Fafixxx96/Embedded-Programming/schema.PNG

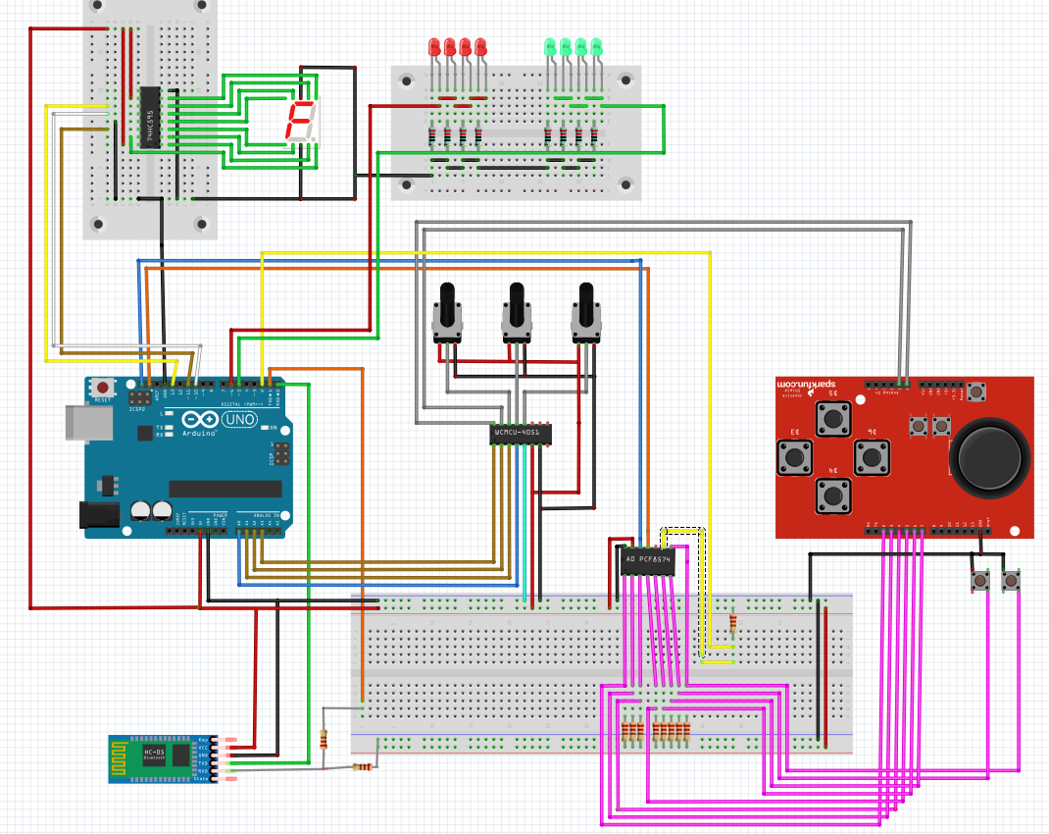
schema.PNG
