Fafixxx96/Embedded-Programming/Low Level_FabioC_214490.pdf

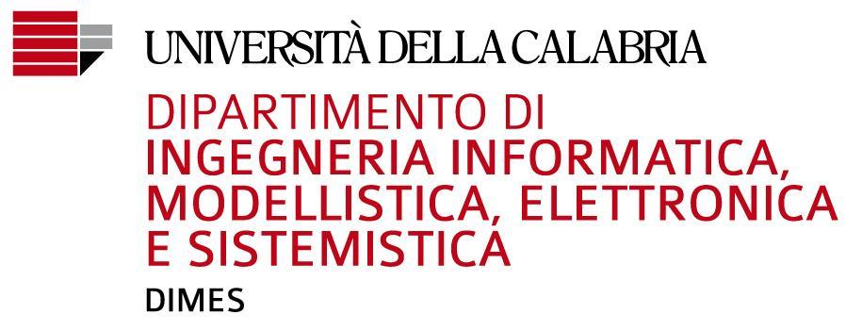
[picture p2: figure]

## University degree in Computer Engineering for the Internet of Things

## Course of Low level and embedded system programming

## Project

## “Steering wheel and pedals with ATmega328p”

Professor
Furfaro Angelo

Teaching assistant
Felicetti Carmelo

Candidate
Fabio Capparelli 214490

## Session 2019/2020

## Introduction

The aim of this project has been to develop a steering wheel and pedals for playing

to car games.

The game used for testing the prototype has been F1 2017 (formula uno 2017) and the

MCU used belongs to ATmega family, the ATmega328p installed on the Arduino platform,

that we studied during the practical lectures.

The main goal is to implement a sort of gamepad that provides a lot of

functionalities and properties, such as a joystick and button to move inside the menu

game, the steering and pedals for driving, and at the end the most important property has

been the power reduction of the prototype. Essentially, I wanted to develop a prototype

that communicates with the game through bluetooth connection and by using interrupt

programming I can reduce so much as possible the power consumption of the board by

putting the CPU in sleep mode.

## Used components

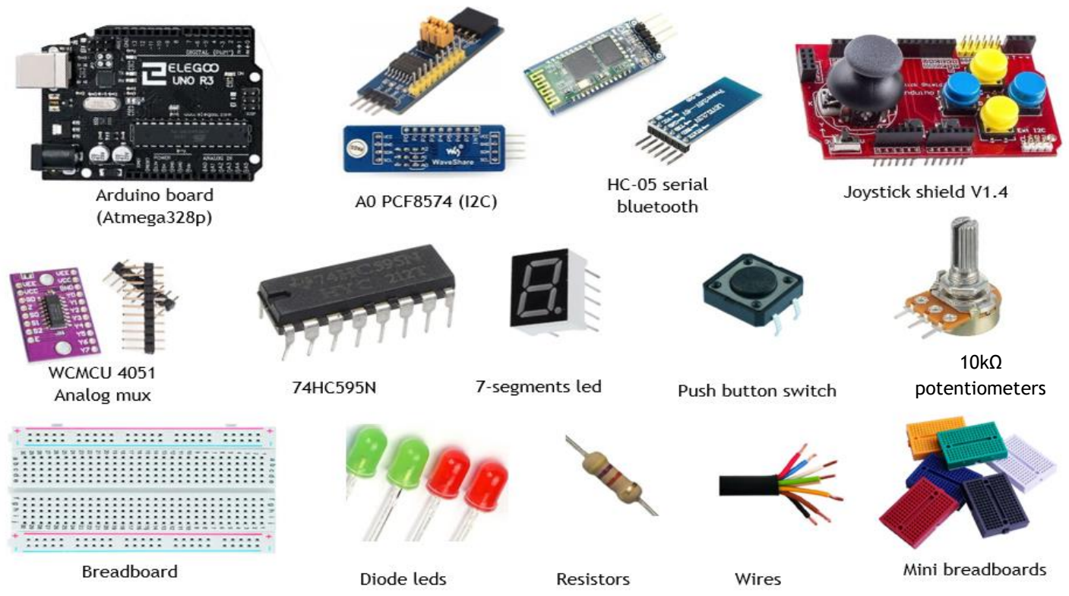
[picture p3: figure]
10kΩ potentiometers

- 1 x Arduino board with ATmega328p.
- 1 x A0 PCF8574 (i2c).
- 1 x HC-05 bluetooth serial.
- 1 x Joystick shield V1.A.
- 1 x WCMCU 4051.
- 1 x 74HC595N.
- 1 x 7-segments led.
- 2 x switch buttons.
- 3 x 10kΩ potentiometers.
- 1 x breadboard.
- 4 x green leds.
- 4 x red leds.
- N x resistors (220, 330, 1k, 2k 10k)
- N x colored wires.
- 4 x mini breadboards.

## Schema

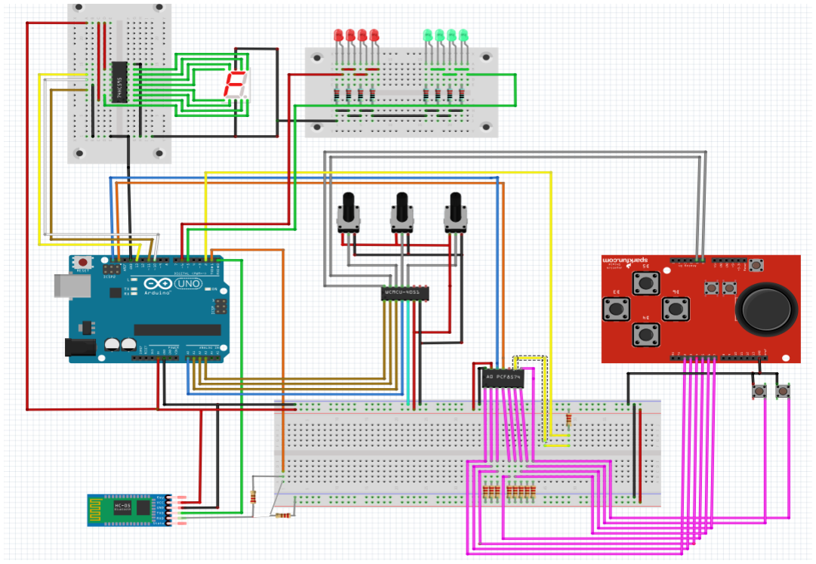
[picture p4: figure]

- ATmega328p → this is the MCU used to implement the entire project.
- PCF8574 → this is an I2C device based on the extending of digital pins of Arduino

using the i2c bus interface, a very nice feature of this component is the INT pin,

that stands for interrupt and allow to us to check if a change of the value of D0 , …

, D7 on the device occurs. This pin follows the open drain policy and it is kept to

high level through a 10kΩ resistor and should be used with ATmega328p external

interrupt on the falling edge or low level of the signal.

- HC-05 → it is a bluetooth module that allow to us a bluetooth serial communication

on COM8 of my PC.

- Joystick shield V1.A → this is a shield compatible with Arduino board, it is used to

simulate a real controller with a joystick and 6 buttons similar to A, B, X, Y, start

and select of Xbox controller.

- WCMCU 4051 → like 7HC4051, essentially it is an analog multiplexer, it can take 3

selection bits and can extends almost 8 analog pins. For the prototype is very useful

because there are 5 analog potentiometers to control, and the analog pins available

are only four, due to the usage of the SDA and SCL i2c pins that are located on the

PORTC where we can find the A4 and A5 pins.

- 7-segments led → used to display the gear.
- Switch buttons → useful to implement L1 and R1 bumper of Xbox controller,

typically for the gear up and gear down.

- Potentiometers → they are most important components, 2 are used to implement

the accelerator and the brake/reverse pedals and the last is used for controlling

the steering wheel.

- Leds → green leds used with Fast PWM mode of timer0, when the accelerator pedal

is pushed down the leds intensity increases, when I release it, they are decreased.

Similar for the brake/revers pedal but with red leds.

## Circuit behavior

The principle behavior of the circuit and project is to implement Xbox controller, for this

reason is useful the following table in order to understand better which components are

adopted for which Xbox buttons.

Components | Xbox | Driving behavior
1 st button on Joystick shield | Y | Button 1
nd button on 2 Joystick shield | B | Button 2
3 rd button on Joystick shield | X | Button 3
th button on 4 Joystick shield | A | Button 4
5 th button on Joystick shield | Start | Button 5
th button on 6 Joystick shield | Select/back | Button 6
Analog joystick on Joystick shield | Left X, Left Y | HAxis1, HAxis2 | Move up/down and left/right
st switch button 1 | L1 bumper | Button 7 | Gear down
2 nd switch button | R1 bumper | Button 8 | Gear up
st potentiometer 1 | L2 trigger | Axis 5 | Break/reverse
2 nd potentiometer | R2 trigger | Axis 4 | Accelerate
rd potentiometer 3 | Right X | IHAxis 3 | Steering

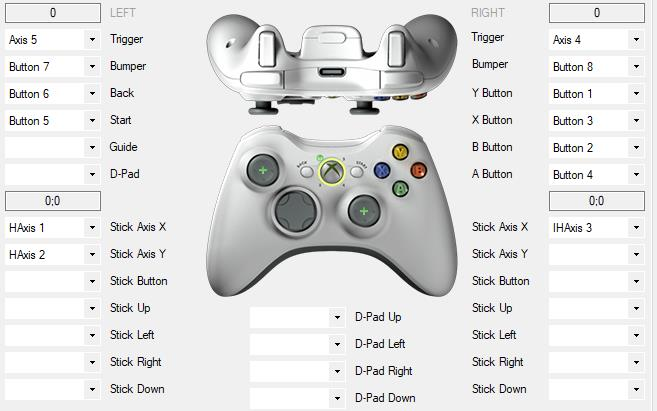
[picture p5: figure]

This picture shows how our components are translated into a an xbox360 controller.

Now will be explained the entire behavior of the circuit, I’m going to explain components

per components following the previous circuital schema from left to right.

The first component that we can see is the bluetooth module, the HC-05 device. This

module is based on seriale communication and it can operate in both slave and master

mode. For my purpose it is a slave, that takes values from the circuit and put them into a

serial channel. It has from 4 pins (VCC, GND, TX and RX) the VCC is connected to 5V of

breadboard and also GND to GND of breadboard. Particular attention on TX and RX pins,

the TX pin can be connected directly to RX pin of Arduino, but the RX pin of HC-05 has to

connect in a differ way to TX of Arduino, because it works at 3.3 volt, and if we connect

them directly it takes the 5 volt. For this reason, is useful to perform a voltage divider or

using a voltage level device. What is a voltage divider? Essentially, I’m going to use 2

resistors connected to RX pin of HC-05, one of 1kΩ goes to TX pin of Arduino and the

second of 2kΩ goes to GND. In this way only 2/3 of 5 volt goes into RX pin and 1/3 goes to

GND. At the end the RX take 3.33 volt.

The second and third components used are the 7-segments led and the 74HC595, so

essentially I’m using the 74HC595 device for controlling which segments has to be on or

off, this two components are used to display the actual gear. It is essentially an analog multiplexer, but it is used in SPI mode, it takes a packet of a byte and based on the value

of the bits puts on or of the segments. It is displayed value from 0 to 7, related to gear

state of a formula uno game.

On the right we can find 8 leds, 4 red and 4 green. The greens are connected to OC0A the

6

th pin of Arduino whereby using fast PWM mode of Timer0 the intensity of these leds

increases or decreases based on the value of the accelerator pedal. Similar for red leds, but they are connected OC0B the 5th pin of Arduino and based on the value of the

break/reverse pedal their intensity changes. Each leds takes the GND through a 220 Ω

resistor.

Now we are going to see the WMCMU 4051 or the 74HC4051, it is an analog multiplexer,

takes three selection signals from PORTC (PC1, PC2, PC3) to select which of the 5

potentiometers have to put value on the ADC module. This components in connected to 5 volt and GND and has an enable pin E̅ connected to GND in this way it is always enabled.

The Z pin is the output pin, where the selected potentiometer puts his analog value. In

the software part we are going to enable the ADC peripheral only for A0 pin the PC0 on

port C. The potentiometers connected are:

- 000 - Y0 pin → left X axis from the joystick shield
- 001 - Y1 pin → left Y axis from the joystick shield
- 010 - Y2 pin → accelerator from a 10kΩ potentiometer (R2 trigger)
- 011 - Y3 pin → break/revers from 10kΩ potentiometer (L2 trigger)
- 100 - Y4 pin → steering wheel from 10kΩ potentiometer (right X joystick)

At the end we have the PCF8574 i2c device. It is connected through the i2c bus interface,

as a slave device. It is used to check if a button is pushed by using an external interrupt.

As we say it send a packet of 8 bits (kept always high through 330Ω resistor to 5v, 1111

1111) when a button is pushed the referring bit goes to 0, the device check that a change

occurred and enable the INT pin, put it to low (open drain) and the MCU sees that a falling

edge is occurred on the INT signal and will read the packet send out by the slave. This

slave has 0x20 salve address. The buttons connected to it is the 6 buttons of the joystick

shield and the 2 switch buttons for the gear.

## Prototype structure

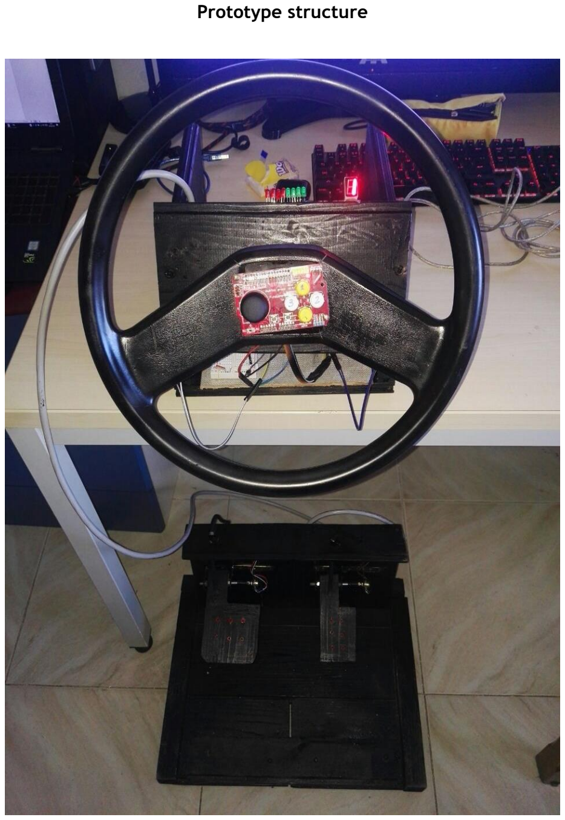
[picture p6: page 8]
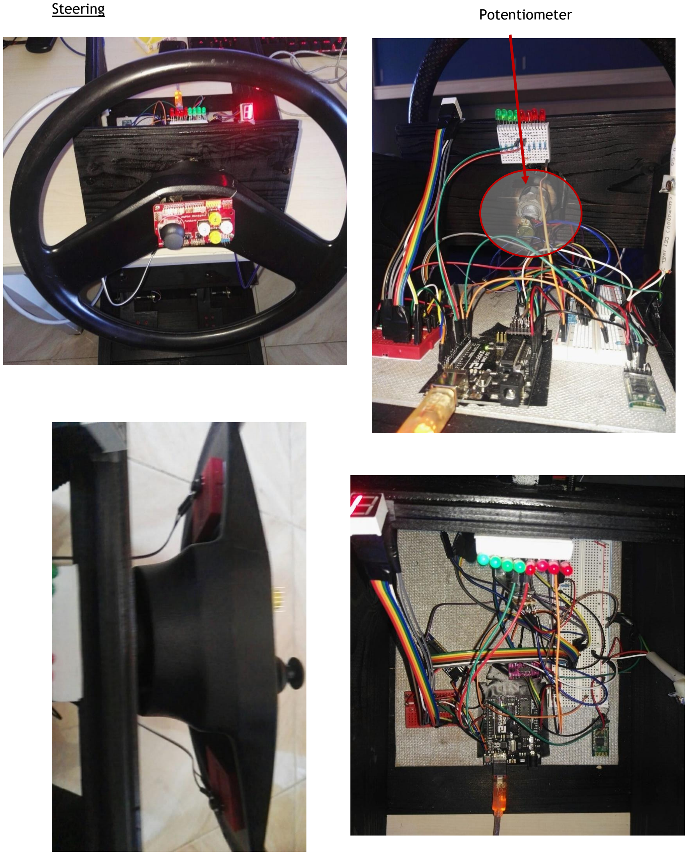
[picture p7: page 9]

Steering | Potentiometer

Pedals

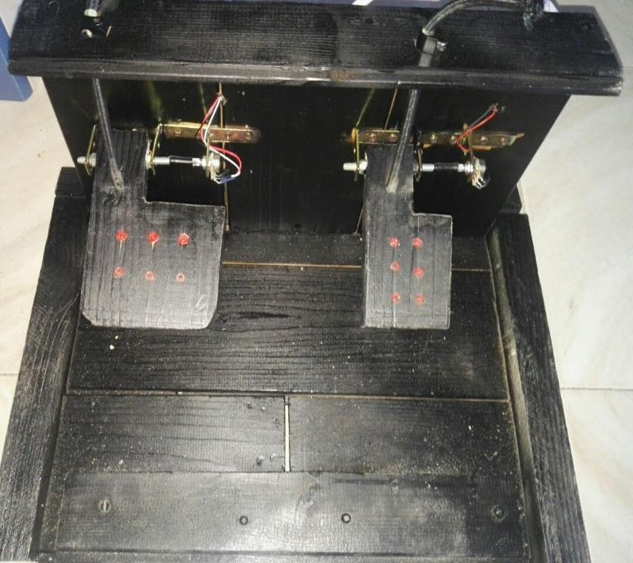
[picture p8: figure]
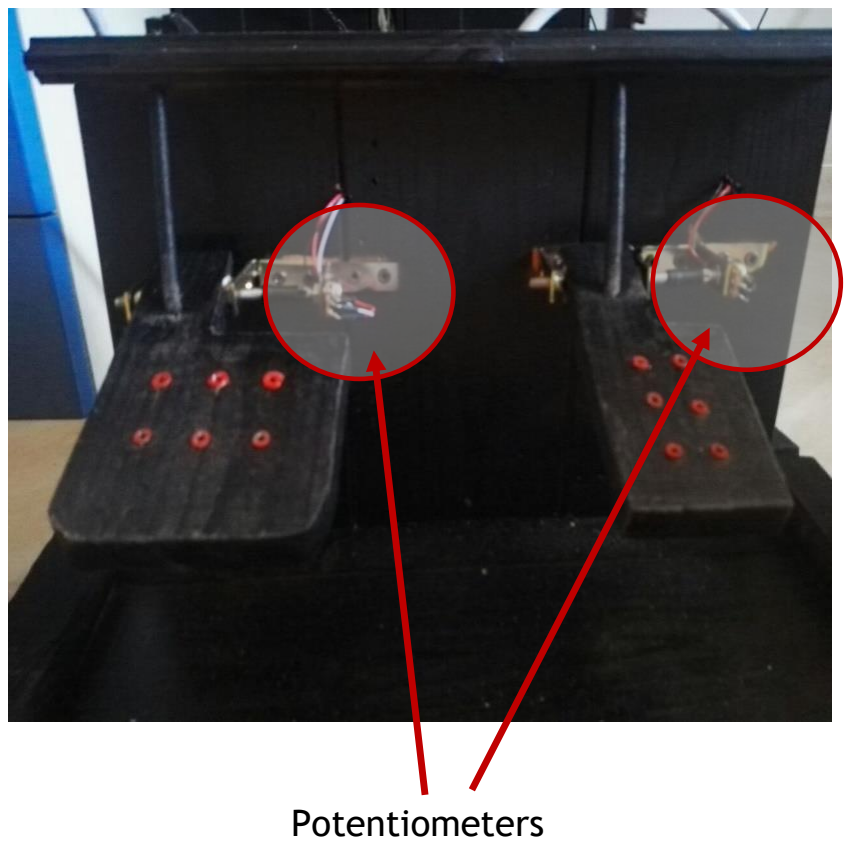
[picture p9: figure]
Potentiometers

The whole structure is built entirely in wood, only the steering is not in wood, it is an

old steering wheel of a Fiat PANDA. At the end all has been colored in black.

## Software part

Now will be provided a detailed explanation of software part of the project. All circuit

code is written in C, and the MCU peripheral programmed have been:

- ADC peripheral → used to convert the analog value of the potentiometer.
- USART peripheral → used to send out the value caught from the components.
- SPI interface → used for 7-segments led.
- I2c interface → used for PCF8574 device.
- Interrupt Unit → used to program:
- ADC_vect interrupt
- USART_UDR0_vect interrupt
- INT0_vect interrupt
- TIMER1_OVF_vect interrupt
- SPI_STC_vect interrupt
- Timer/Counter peripheral → Timer1 used for counts 0.032 sec, this is the period to

used to send out the value from USART, the Timer0 used to wave form generator

in fast PWM mode with OC0A and OC0B.

Essentially the behavior of the C program is that: takes value each 0.032 from the analog

potentiometer and send it out. When a button is pushed an external interrupt occurs and

send out the value of the pushed button through PCF8574 and i2c bus interface, if will be

pushed the gear up / down button the 7segments led, through the SPI peripheral,

increment or decrement the value from 0 to 7.

All the data is sent through bluetooth serial using COM8 port on my windows machine, a

python script takes and read the value, manipulate them and by using a virtual joystick

configured by vJoy app the events are mapped.

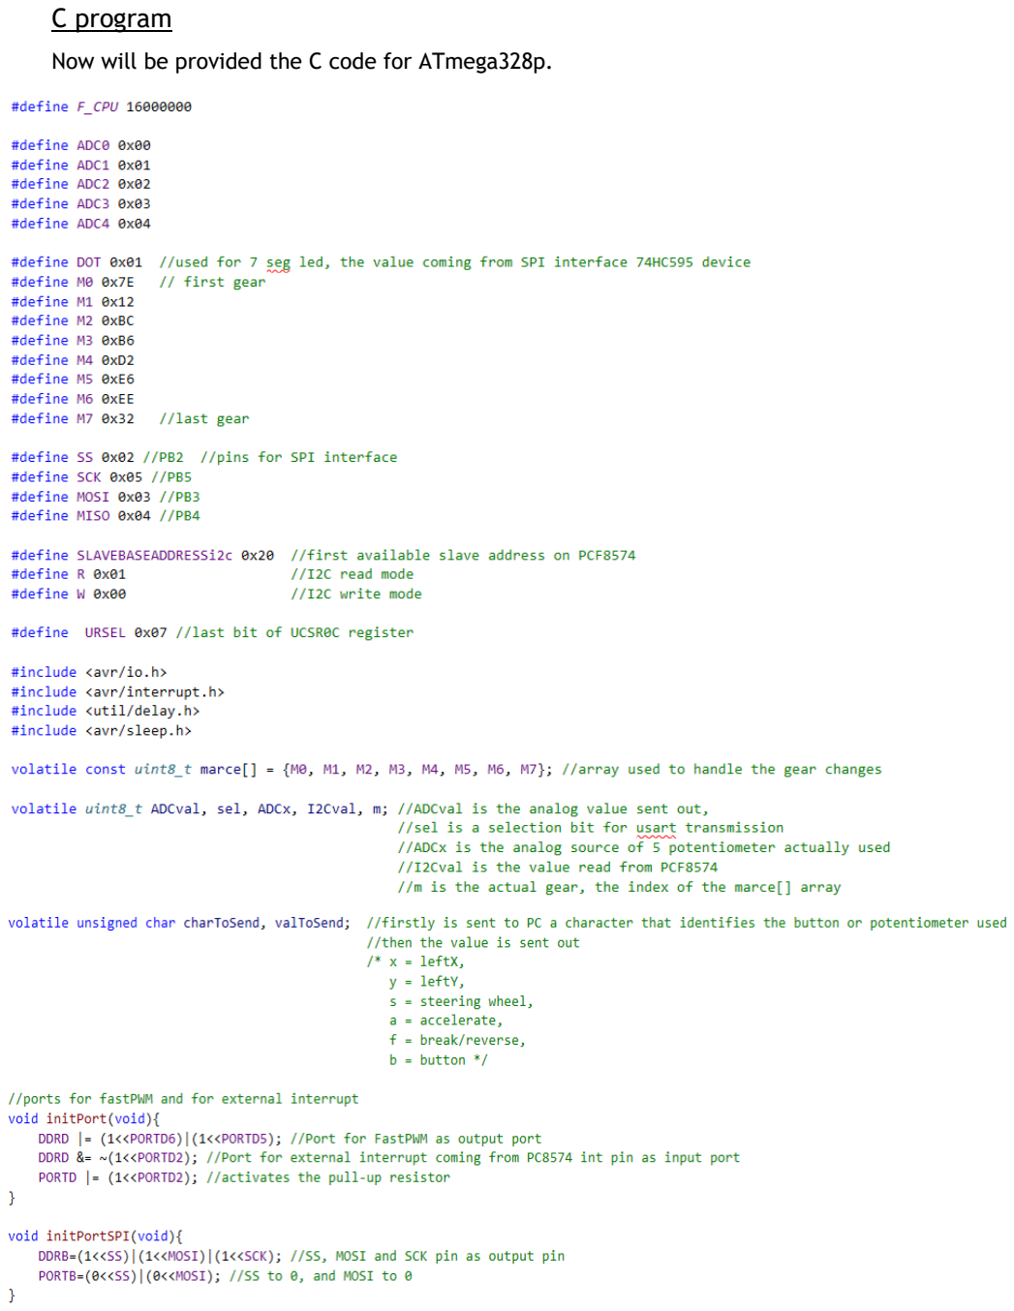
[picture p10: page 12]

C program

Now will be provided the C code for ATmega328p.

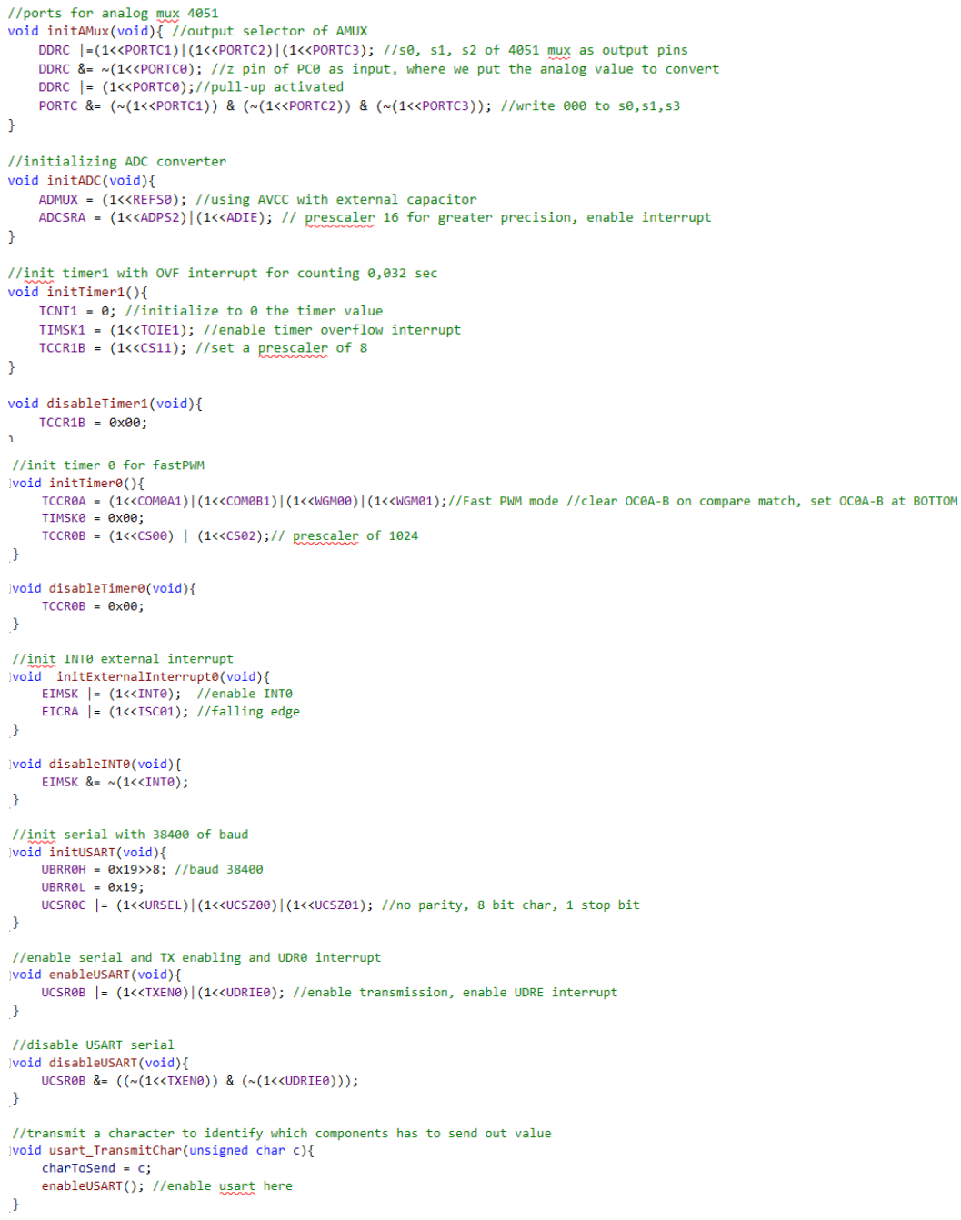
[picture p11: page 13]
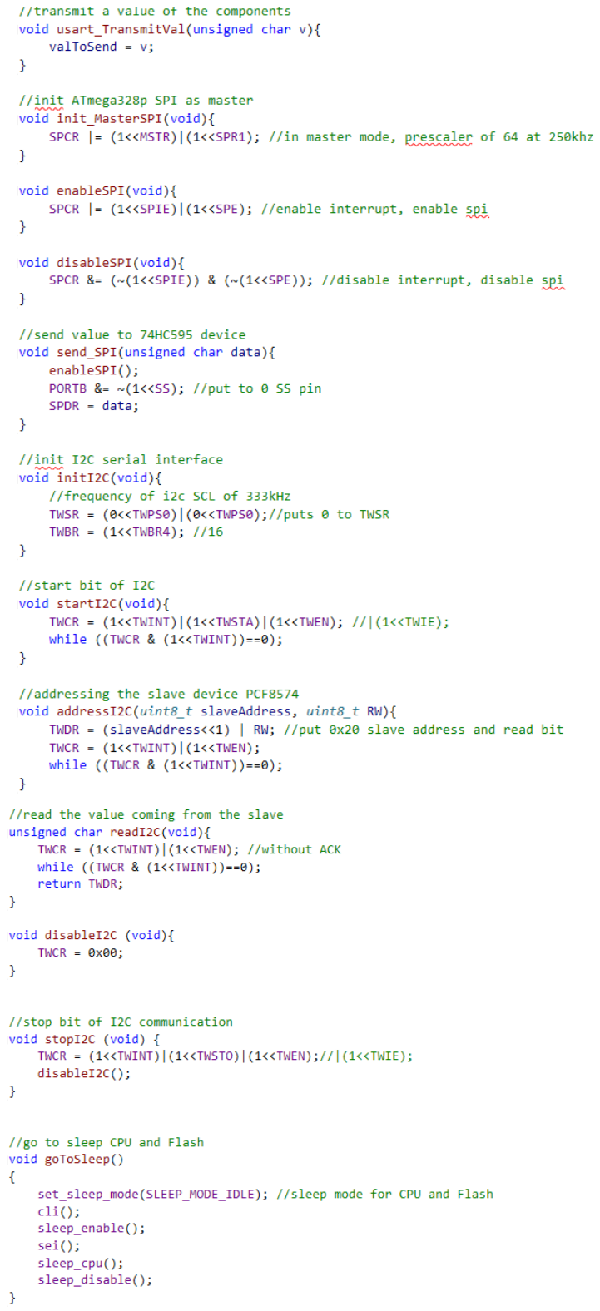
[picture p12: page 14]
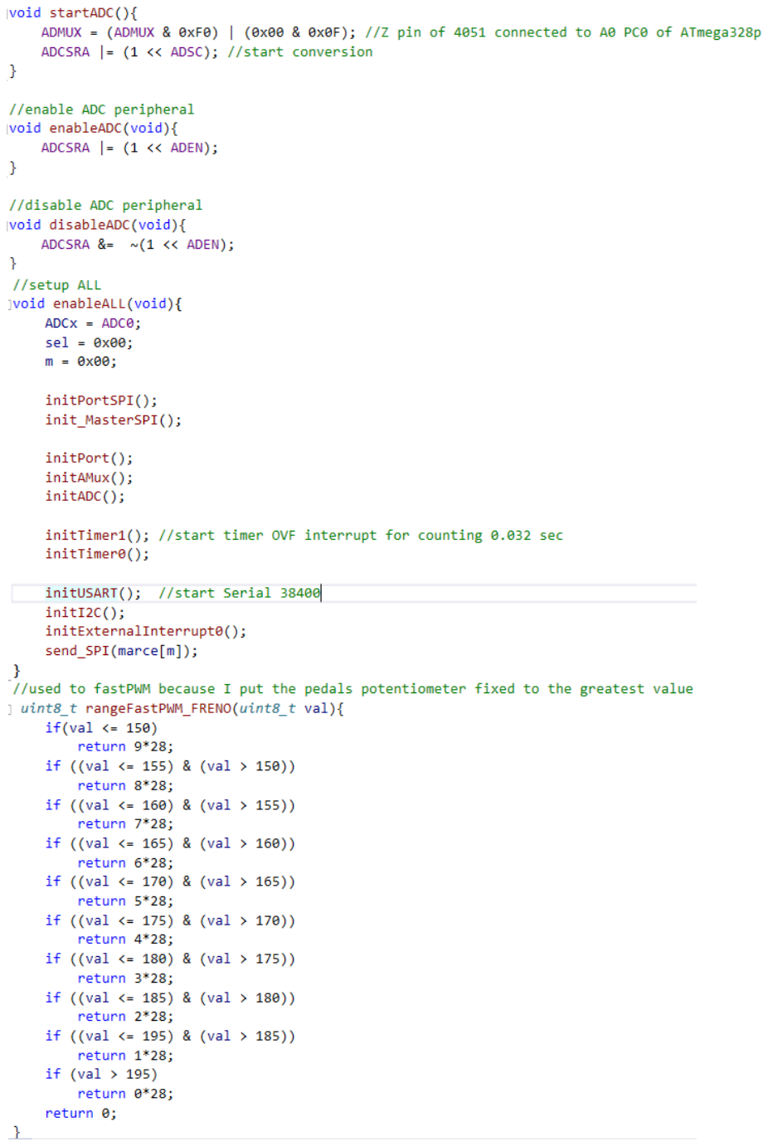
[picture p13: page 15]
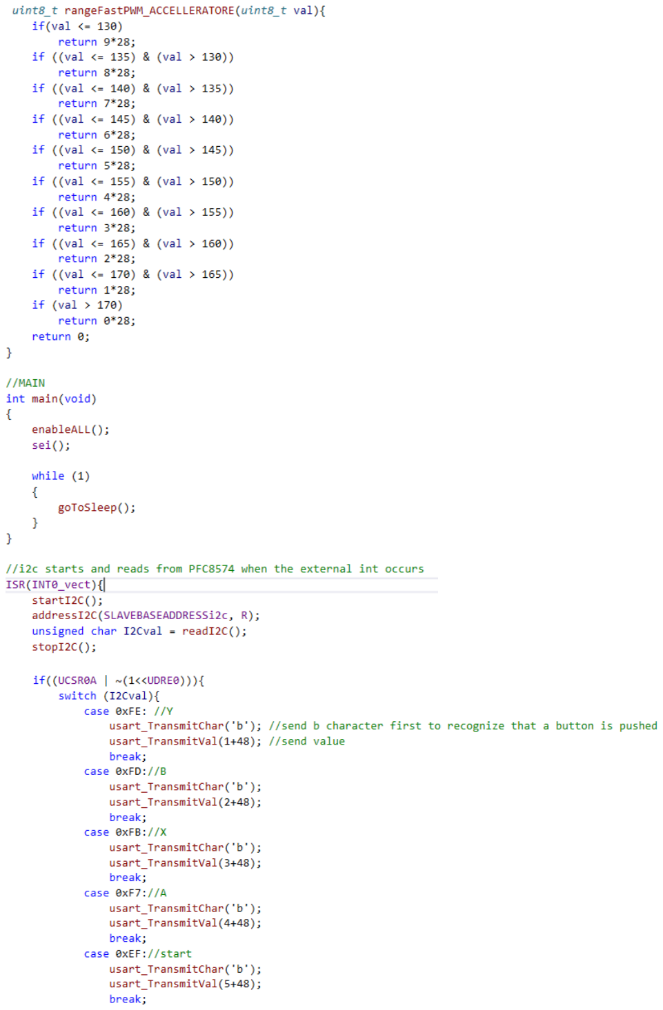
[picture p14: page 16]
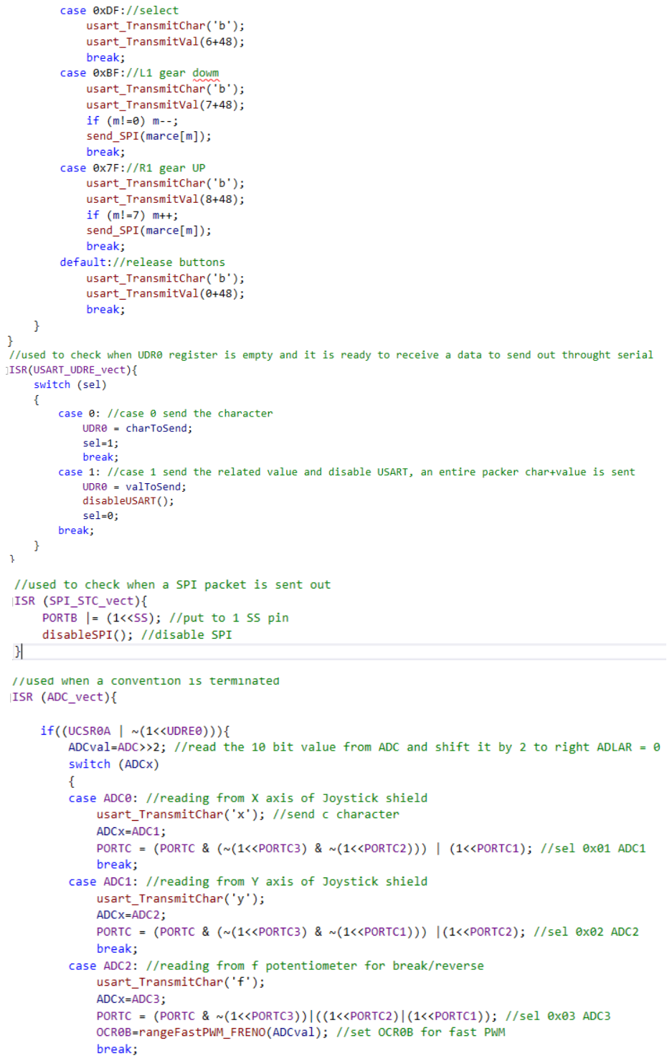
[picture p15: page 17]

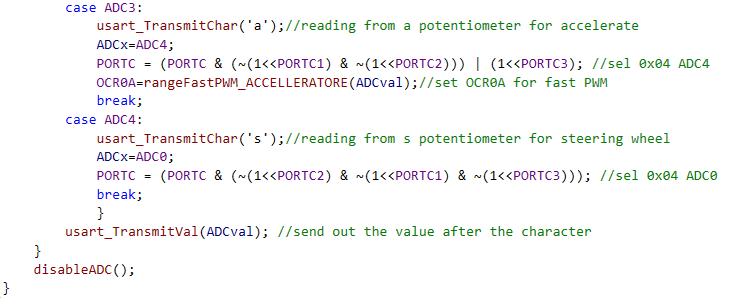
[picture p16: figure]

All is programmed by using interrupt, the only polling mode is in the i2c interface

communication, I tried a lot to use the TWI_vect but the code doesn’t work well, also I

searched online this problem and I found that it is very common, the start conditions,

sending of address, read/write data and stop condition with TWI_vect don’t work fine,

due to the fact that there are many interrupt service routines that can occur

concurrently that have a greater priority.

vJoy Monitor used to check the behavior of the controller.

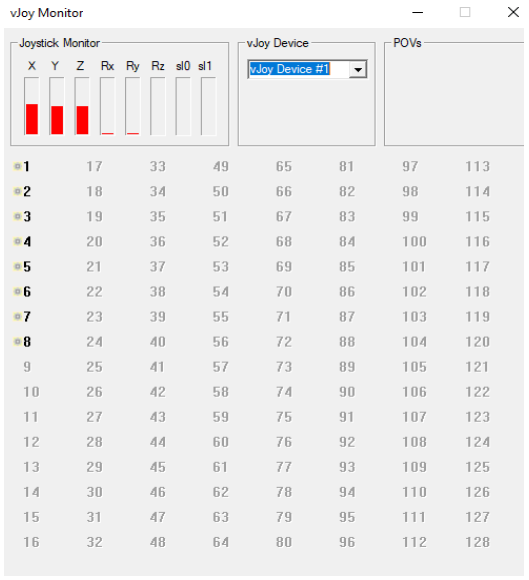
[picture p17: figure]
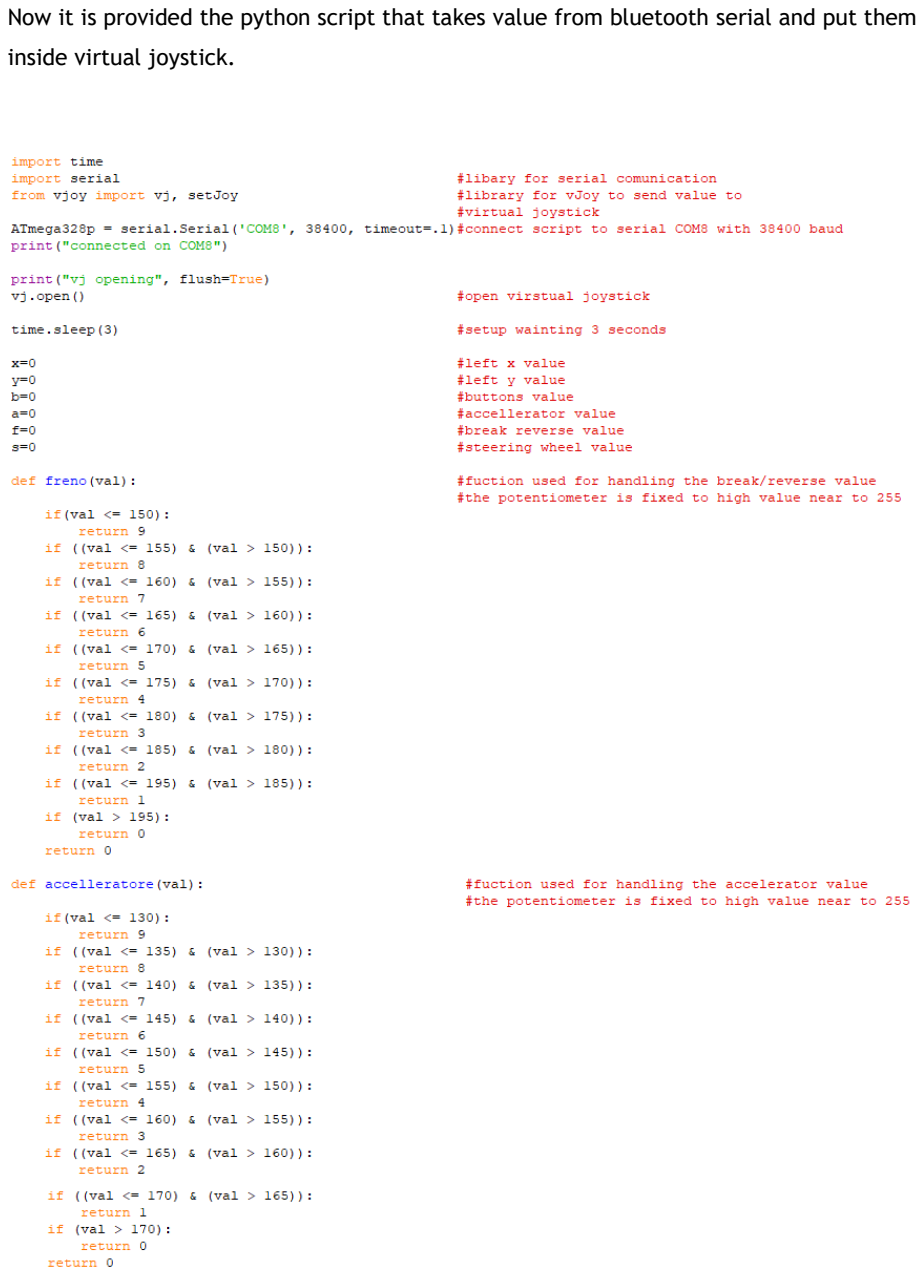
[picture p18: page 19]

Now it is provided the python script that takes value from bluetooth serial and put them

inside virtual joystick.

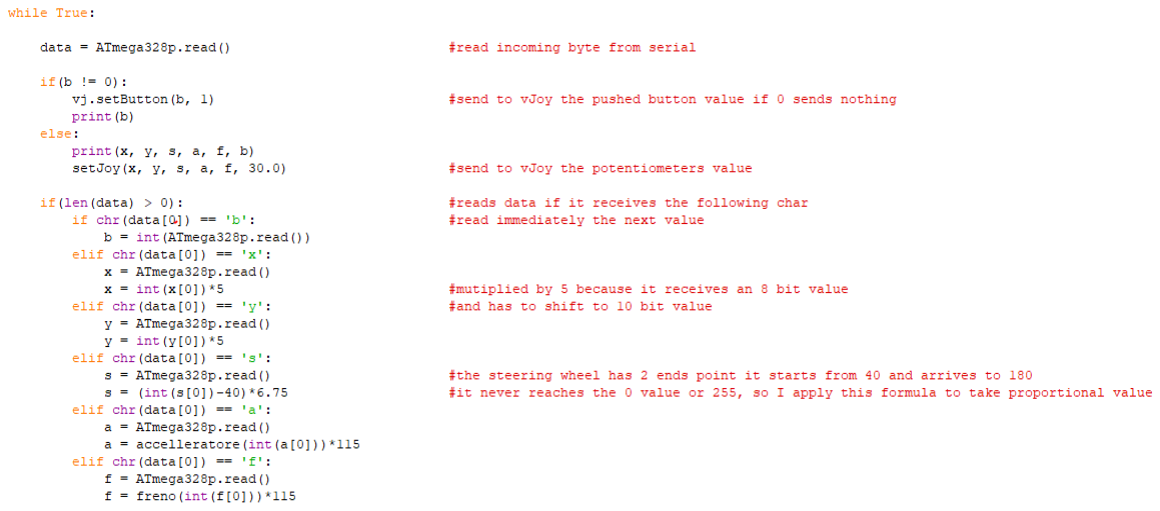
[picture p19: figure]
